tinytronix/Leselicht/README.md

Dieses Elektronik/Software-Projekt ist Teil meines Projektes "ich baue ein Bett mit viel Stauraum".
Mit einem Wemos D1 Mini und zwei WS2812B LED-Stripes wird ein Leselicht und eine Effektbeleuchtung realisiert.
Die LED-Stripes sind in das Bett eingebaut. Bedient wird das ganze mit einem optischen Dreh-Drücksteller der Firma Grayhill.
Im wesentlichen geht es hier um die Elektronik und die Software, aber unter Hardware findet sich auch eine [Konstruktionszeichnung](https://github.com/tinytronix/Leselicht/blob/master/Hardware/Konstruktion.pdf) für die Holzzuschnitte. Das Bett habe ich mit  dieser Konstruktionszeichnung inzw. 2x gebaut, die Maße sollten also stimmen. 

# Features
- Leselicht warm/weiß
- verschiedene Licht-Effekt
- Fake-TV zur Anwesenheitssimulation (angebunden an meine [Hausautomation](https://github.com/tinytronix/homeautomation))
- Lichsensor: Bettlicht an, wenn Raumlicht ausgeschaltet wird
- Konfiguration Web-Browser
- zwei Temperatursensoren
- Auslesen Temperatur, Raumhelligkeit und Systemzustände per WLAN

# Fotos
Die Hardware
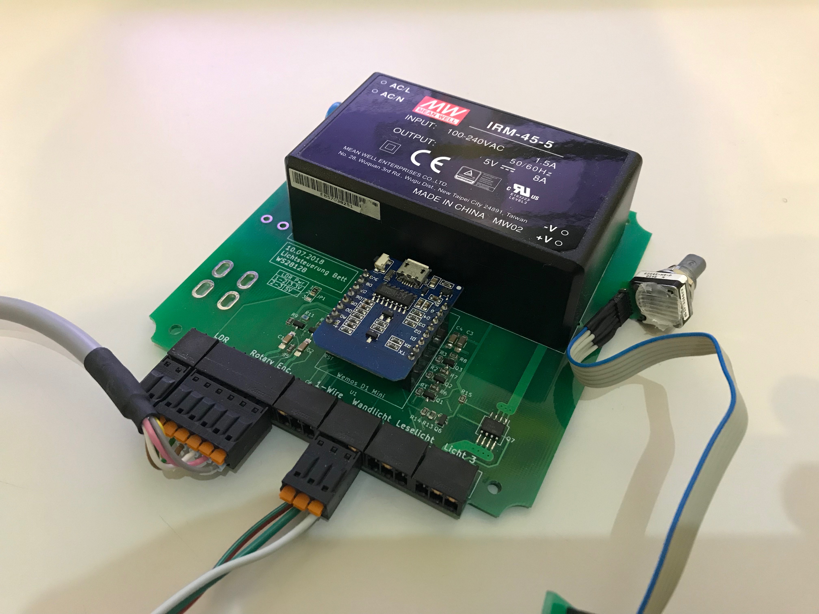
[picture p1: Photos/Hardware2.JPG]

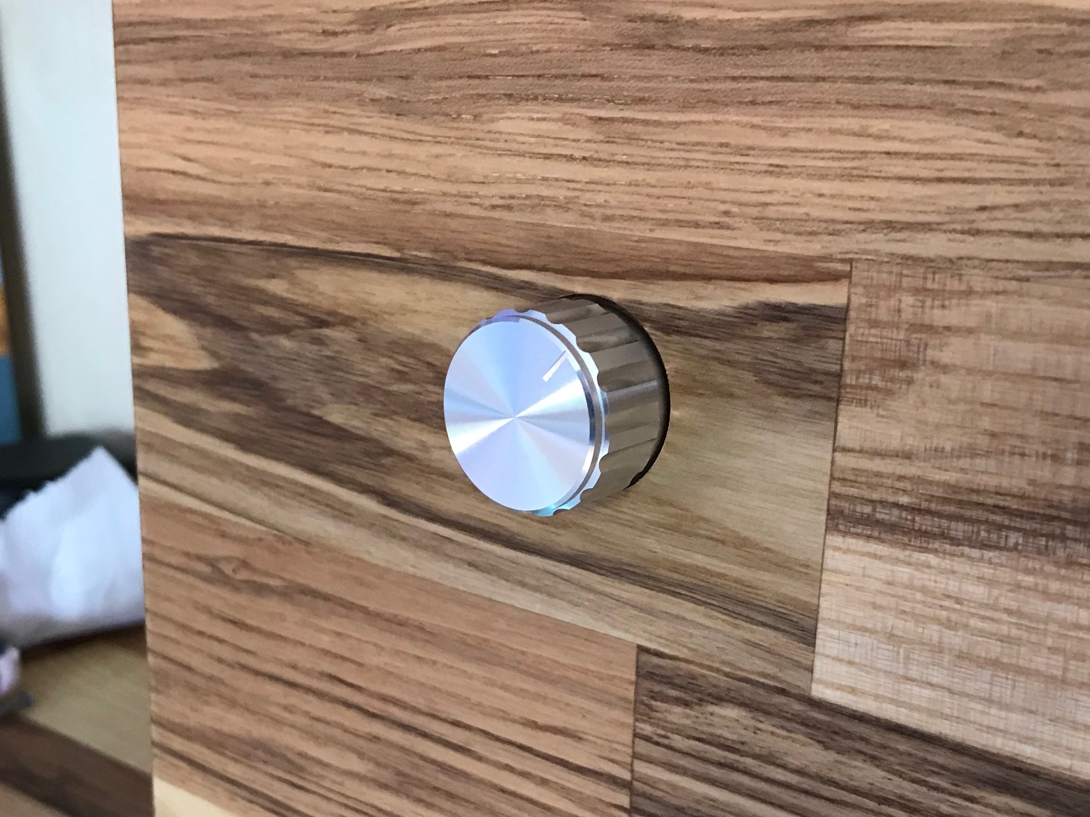
[picture p2: Photos/Drehdrueck2.JPG]

Das Bett:
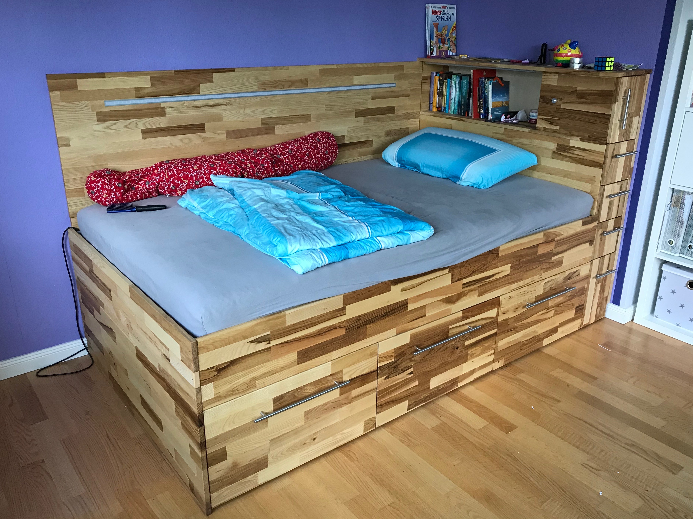
[picture p3: Photos/Bett.JPG]

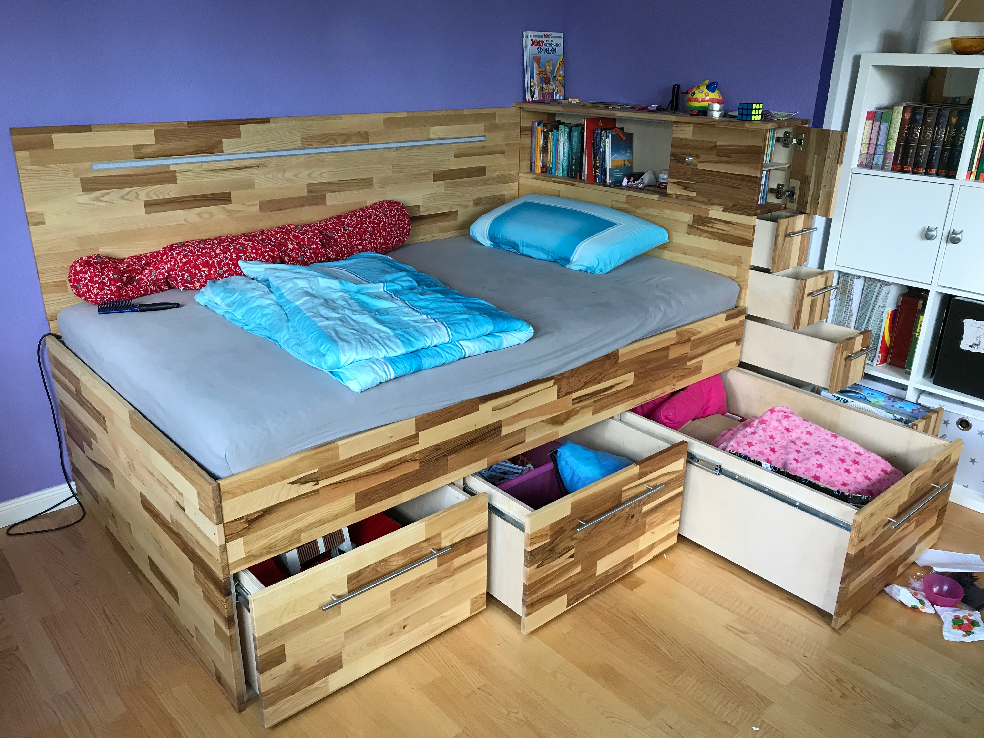
[picture p4: Photos/BettOffen.JPG]

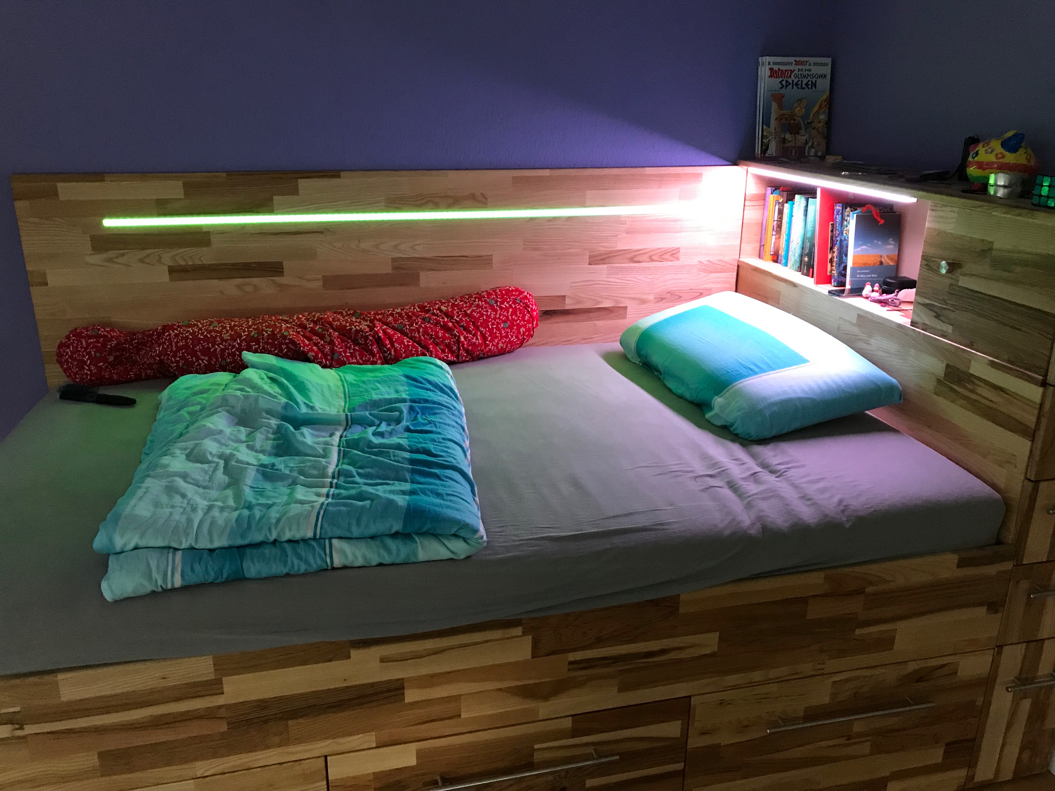
[picture p5: Photos/BettBeleuchtet.JPG]
