tinytronix/Leselicht/Hardware/README.md

Die Gerber files sind "ready to use" und können direkt zu einem PCB Fertiger hochgeladen werden.
