tinytronix/Leselicht/Hardware/Zuschnitt.pdf

Bestelliste Bett (Maße in cm)

Nr | Anzahl | BxH [cm x cm] | Art | Info
1 | 1 | 124,3x64,5 | 28mm Sichtholz | Fußplatte (Alternativ: 25, 26)
2 | 3 | 67,0x122,0 | 9mm Birke Multiplex | Bettkasten Deckplatte
3 | 6 | 45,5x118,5 | 15mm Birke Multiplex | Bettkasten Seitenteile
4 | 3 | 45,5x67,0 | 6mm Birke Multiplex | Bettkasten Rückwand
5 | 3 | 10,0x64,0 | 15mm Birke Multiplex | Bettkasten Leiste vorne unten
6 | 6 | 34,0x99,1 | 15mm Birke Multiplex | Schublade Seitenwand
7 | 3 | 57,1x10,0 | 15mm Birke Multiplex | Schublade Anschraubung f. Front
8 | 3 | 57,1x97,6 | 9mm Birke Multiplex | Schublade Bodenplatte
9 | 2 | 34,0x60,1 | 9mm Birke Multiplex | Schublade Rückwand
10 | 1 | 66,7x36,0 | 18mm Sichtholz | Front Schub Mitte (Platte: 2500x400)
11 | 1 | 66,5x36,0 | 18mm Sichtholz | Front Schub rechts (Platte: 2500x400)
12 | 2 | 33,2x36,0 | 18mm Sichtholz | Front Türen links (Alternativ: 27) (Platte: 2500x400)
13 | 1 | 24,0x200,8 | 18mm Sichtholz | Front Oben quer (Platte: 2500x300)
14 | 1 | 24,3x124,1 | 18mm Buche | Front Fuß Oben (Platte: 2000x300)
15 | 1 | 122,0x92,9 | 18mm Sichtholz | Kopfplatte
16 | 1 | 92,9x20,0 | 15mm Birke Multiplex | Kopf Innen senkrecht
17 | 4 | 110,0x20,0 | 15mm Birke Multiplex | Kopf innen waagerecht
18 | 1 | 122,0x122,7 | 6mm Birke Multiplex | Kopf Rückwand
19 | 1 | 122,0x22,4 | 18mm Sichtholz | Kopf Bücherregal Boden (Platte 2500x300)
20 | 1 | 28,0x21,8 | 18mm Sichtholz | Kopf Bücherregal Seitenteil links (Platte 2500x300)
21 | 2 | 28,0x20,0 | 18mm Sichtholz | Kopf Bücherregal Seitenteil rechts (Platte 2500x300)
22 | 1 | 124,6x28,5 | 18mm Sichtholz | Kopf Deckplatte oben (Platte 1500x300)
23 | 1 | 20,0x20,0 | 6mm Birke Multiplex | Kopf Einleger Seitenfach
24 | 1 | 28,0x38,0 | 18mm Sichtholz | Kopf Fachabdeckung (Platte 2500x300)
25 | 1 | 124,3x26,0 | 18mm Sichtholz | Fußplatte Oberteil
26 | 1 | 124,3x37,1 | 18mm Sichtholz | Fußplatte Unterteil
27 | 1 | 66,7x36,0 | 18mm Sichtholz | Front Schub Links
28 | 1 | 122,2x23,1 | 18mm Sichtholz | Tür

Lange Schubladen Johanna (Maße in cm)

29 | 6 | 109,5x16,5 | 6,5mm Birke Multiplex | Lange Schublade Seitenteil
30 | 4 | 109,5x18,5 | 9mm Birke Multiplex | Lange Schublade Boden
31 | 6 | 15,4x18,5 | 9mm Birke Multiplex | Lange Schublade vorne/hinten
32 | 2 | 109,5x29,0 | 6,5mm Birke Multiplex | Lange hohe Schublade Seitenteil
33 | 2 | 27,9x18,5 | 9mm Birke Multiplex | Lange Schublade vorne/hinten
xx | 1 | 21,8x28,7 | 18mm Sichtholz | Kopfteil Tür
xx | 1 | 21,8x19,0 | 18mm Sichtholz | Kopfteil Schublade 1 Front
xx | 1 | 21,8x18,0 | 18mm Sichtholz | Kopfteil Schublade 2 Front
xx | 1 | 21,8x18,5 | 18mm Sichtholz | Kopfteil Schublade 3 Front
xx | 1 | 21,8x36,6 | 18mm Sichtholz | Kopfteil Schublade 4 Front
