tinytronix/Leselicht/Hardware/Konstruktion.pdf

# Bett

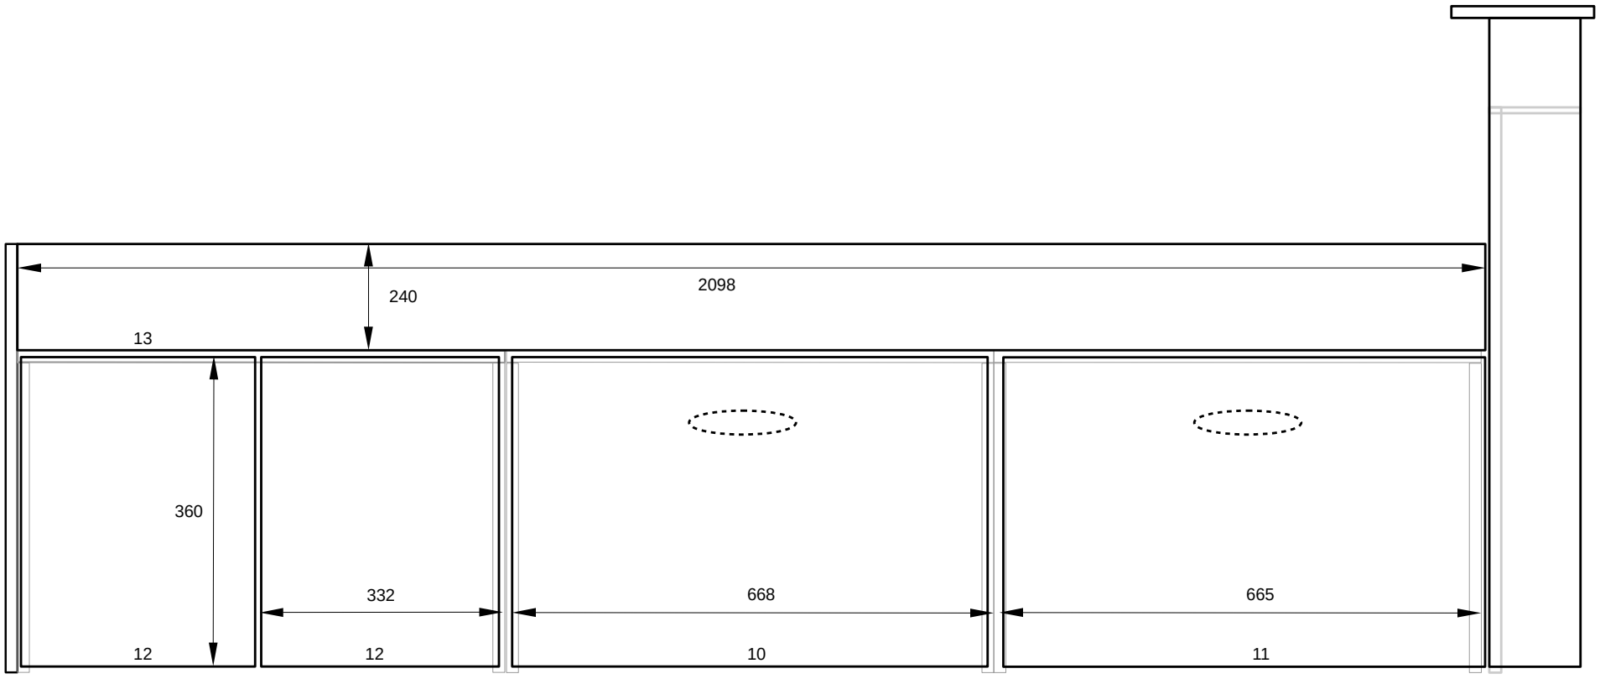
[picture p8: figure]

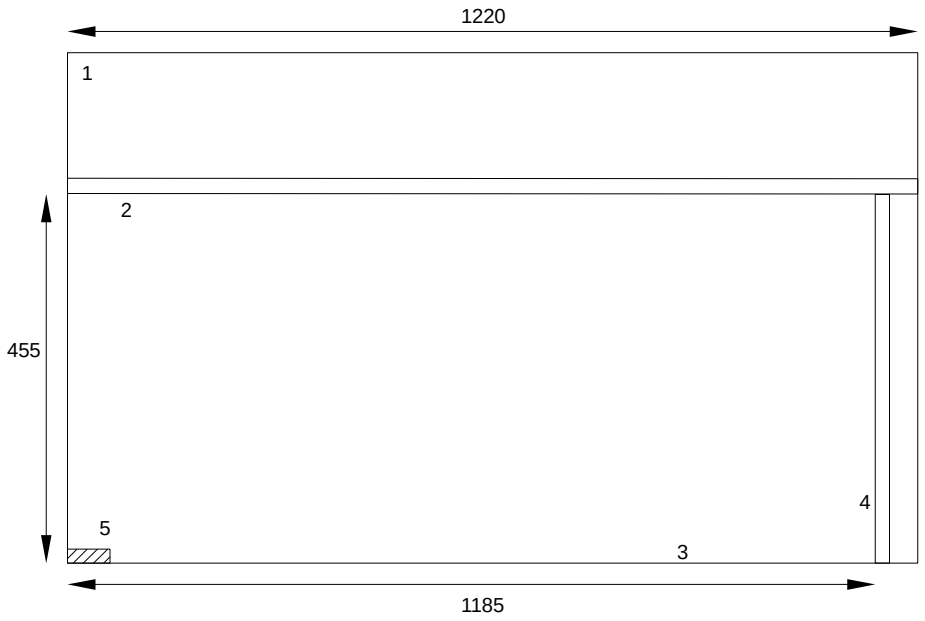
[picture p9: figure]

670
1

2

3

4

Front | Seite

# Bettkasten ohne Einschübe

619

3

455

5

# Schubladen (ohne Front)

# Bettkasten ohne Einschübe

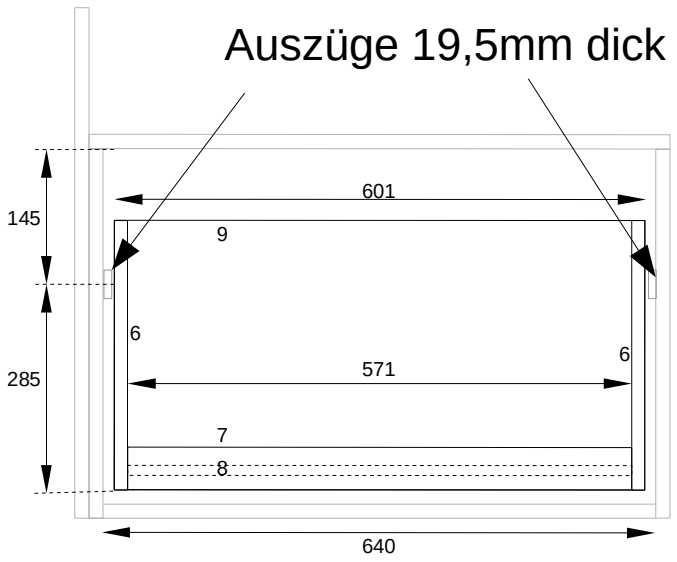
[picture p10: figure]
Auszüge 19,5mm dick
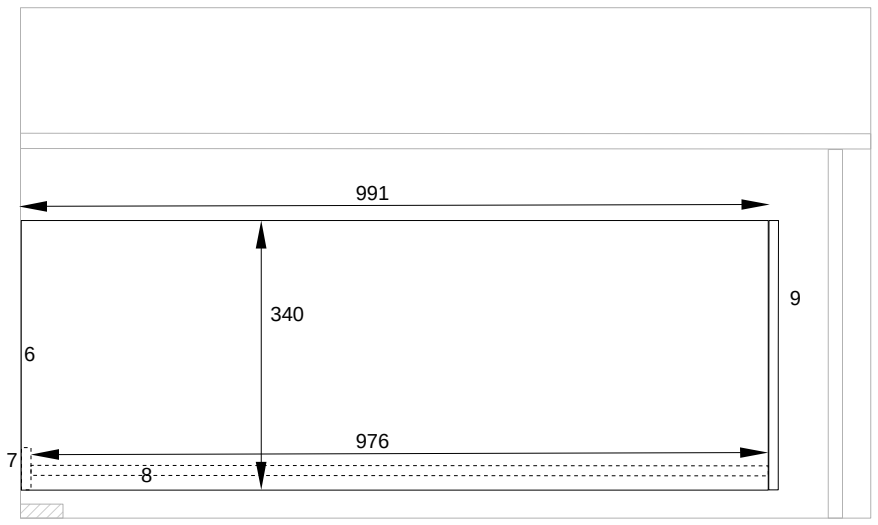
[picture p11: figure]

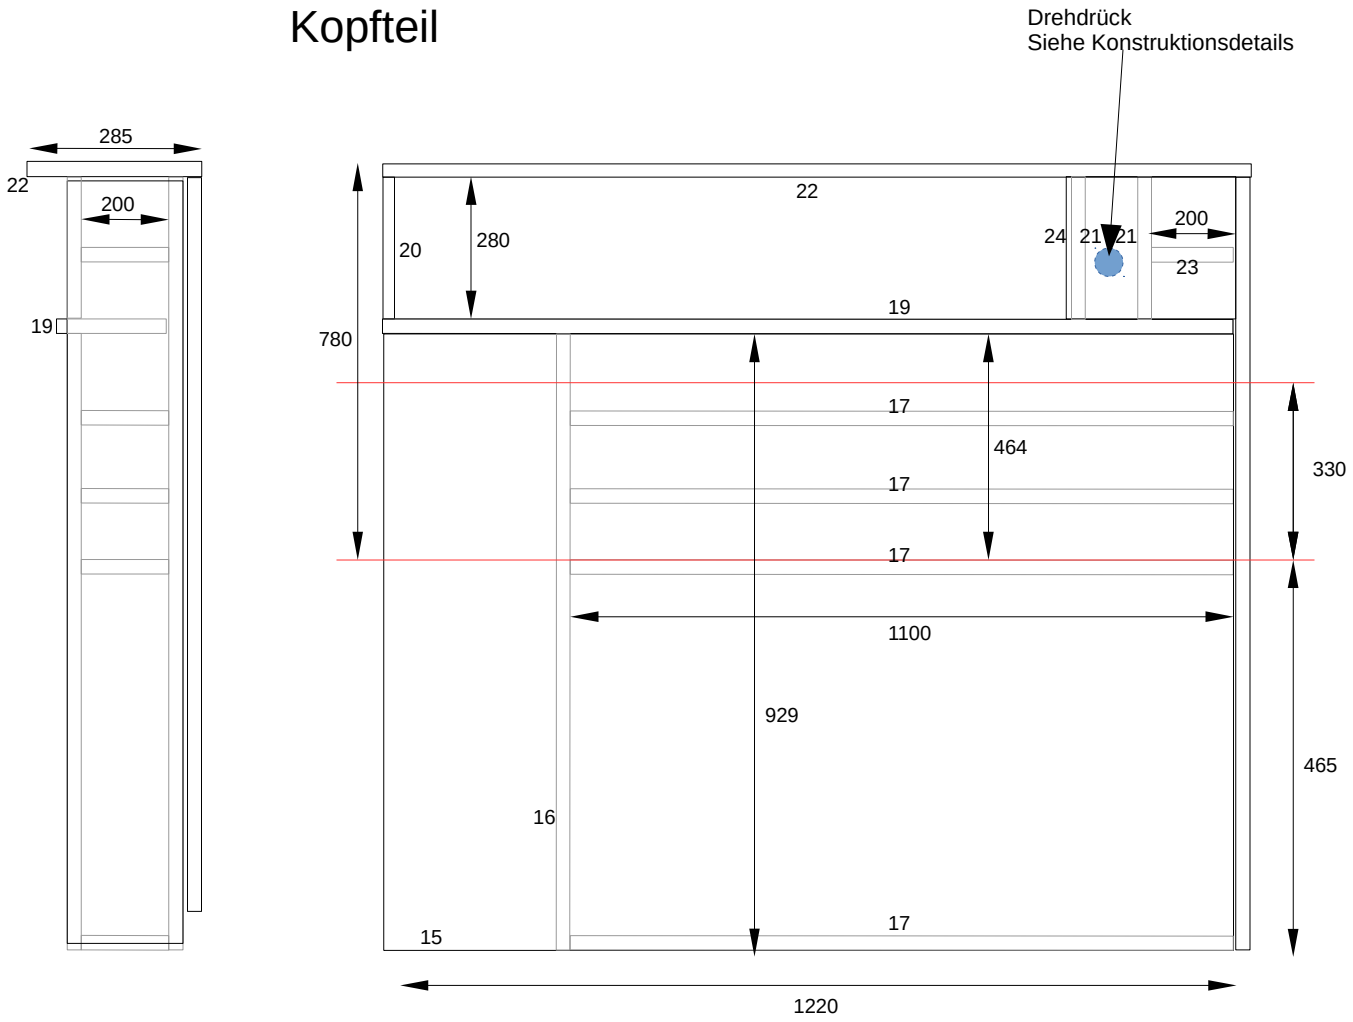
[picture p12: figure]
Kopfteil; Drehdrück Siehe Konstruktionsdetails

# Konstruktionsdetails

Drehdrück | Grayhill 62S Series
Drehdrück Knopf | www.musikding.de | Aluminium Knopf 25mm 565
Lichtschiene Corner 30° | 2M Alu Profil | Ebay Item: 171328930285 Corner 30° Innenmaß 10mm Länge: 2 Meter Breite: 20mm Höhe: 16mm Oberfläche: Natureloxiert opal (milchglas)
Lichtschiene flach | 2M Alu Profil | Ebay Item: 171328930285 Flach Innenmaß 10mm Länge: 2 Meter Breite: 20mm Höhe: 16mm Oberfläche: Natureloxiert Abdeckung: opal (milchglas)
Vollauszüge 900mm SO-Tech | Vollauszüge 80Kg / 250 -1500 mm / Schwerlastauszüge Vollauszug Schubladenauszug 19,5mm dick | Ebay Artnr. 152054023018

Bondex Hartöl 0,75l

500

2200

2

6

1243

371
1

0
360

667

2280

0

218

2200

500

1

5.1

1220

464

2200

500
15.2

1220

464

2200

600

19

1220

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
2010

230

600

12462
285

2

11
360

667

25

1243

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
# Kleine Schubläden

29

30

31 | 31

32

30

33 | 33
