tinytronix/Leselicht/Hardware/Schaltplan_Dredrueck.pdf

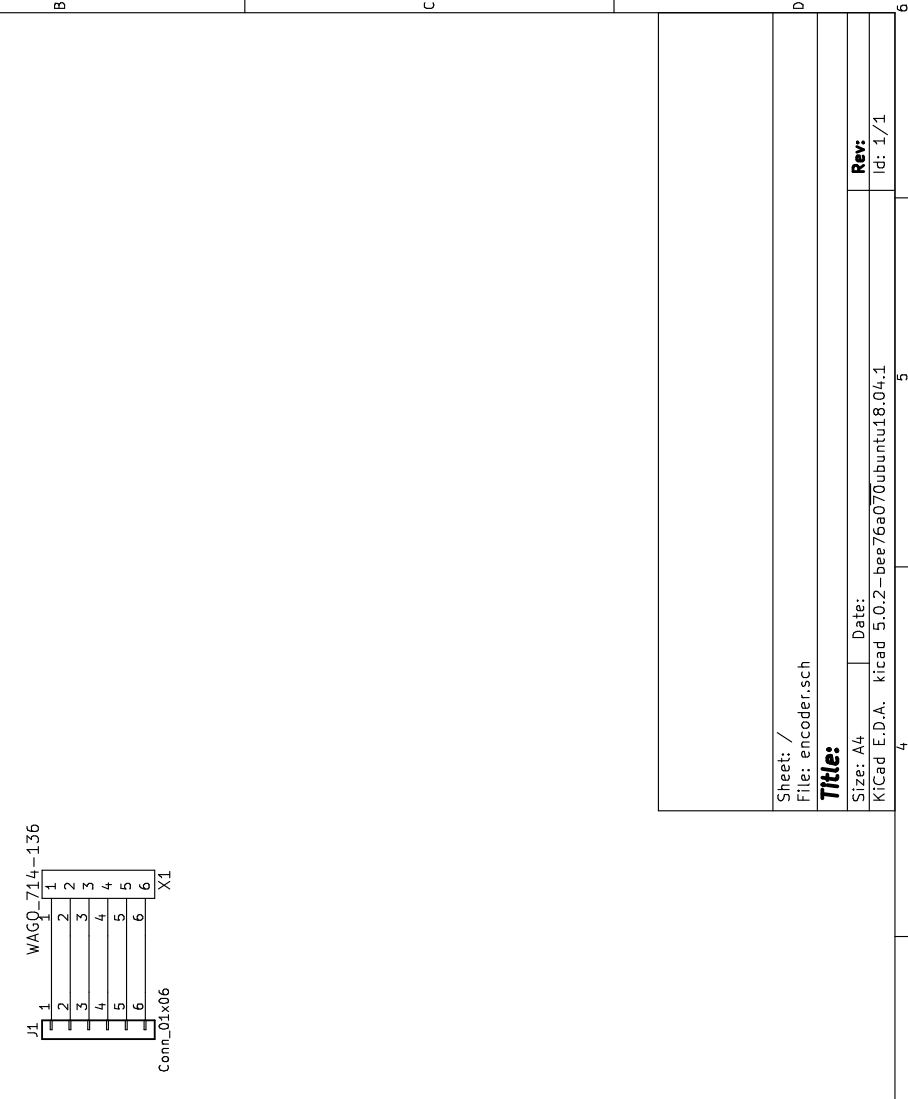
[picture p13: page 1]
