tinytronix/Leselicht/Hardware/Schaltplan_Steuerung.pdf

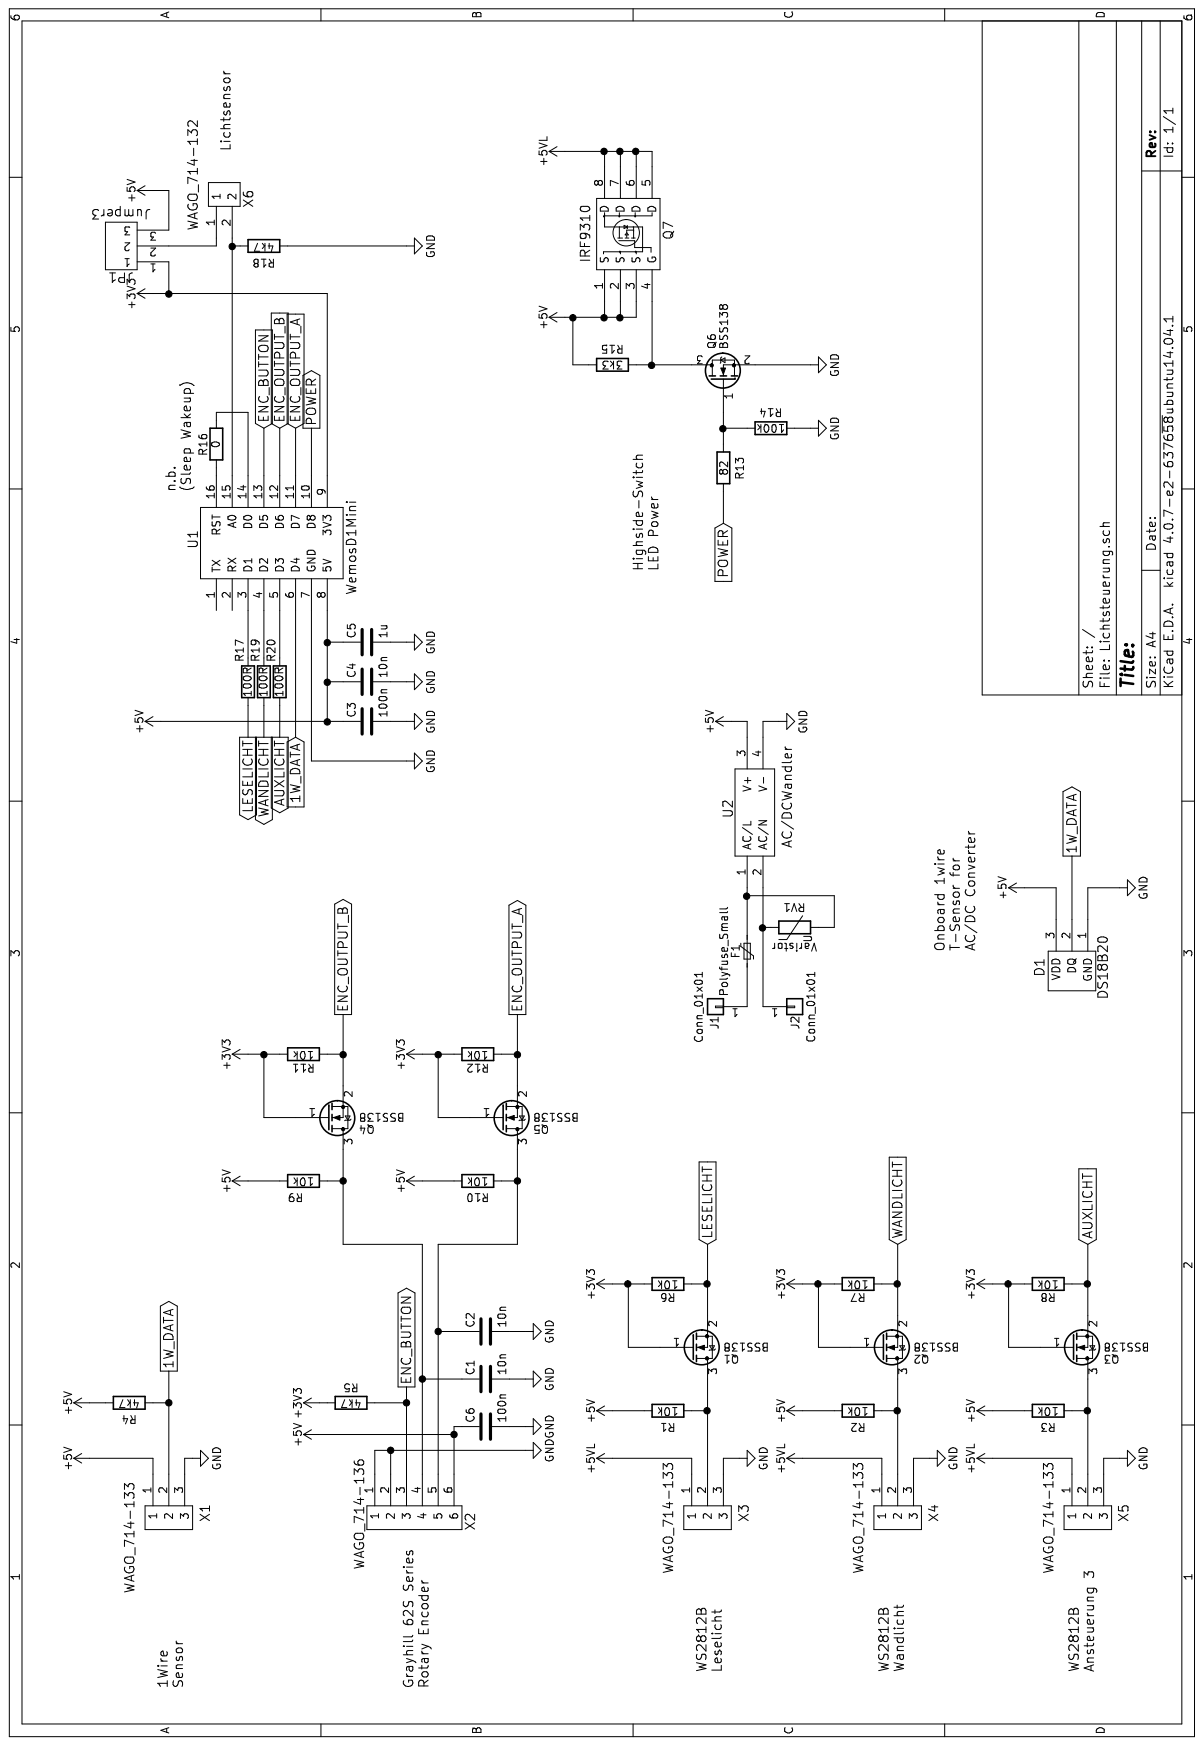
[picture p14: page 1]
