tinytronix/Leselicht/Software/faketv.h

//faketv5.h
const uint8_t  gamma8[] = {
  0X01, 0X01, 0X01, 0X02, 0X02, 0X02, 0X03, 0X03, 0X03, 0X04, 0X04, 0X04,
  0X05, 0X05, 0X05, 0X06, 0X06, 0X06, 0X07, 0X07, 0X07, 0X08, 0X08, 0X08,
  0X09, 0X09, 0X0A, 0X0B, 0X0B, 0X0B, 0X0C, 0X0C, 0X0C, 0X0D, 0X0D, 0X0D,
  0X0E, 0X0E, 0X0E, 0X10, 0X10, 0X10, 0X11, 0X11, 0X11, 0X12, 0X12, 0X12,
  0X14, 0X14, 0X14, 0X15, 0X15, 0X15, 0X17, 0X17, 0X17, 0X18, 0X18, 0X19,
  0X1A, 0X1A, 0X1A, 0X1B, 0X1C, 0X1C, 0X1D, 0X1D, 0X1E, 0X1F, 0X1F, 0X1F,
  0X21, 0X21, 0X21, 0X22, 0X23, 0X23, 0X24, 0X25, 0X25, 0X26, 0X27, 0X27,
  0X28, 0X29, 0X29, 0X2A, 0X2B, 0X2B, 0X2C, 0X2D, 0X2D, 0X2F, 0X2F, 0X30,
  0X31, 0X31, 0X32, 0X33, 0X34, 0X34, 0X36, 0X36, 0X37, 0X38, 0X38, 0X39,
  0X3A, 0X3B, 0X3C, 0X3D, 0X3E, 0X3E, 0X40, 0X40, 0X41, 0X42, 0X43, 0X43,
  0X45, 0X46, 0X46, 0X48, 0X48, 0X49, 0X4B, 0X4B, 0X4C, 0X4E, 0X4E, 0X4F,
  0X50, 0X51, 0X52, 0X54, 0X54, 0X55, 0X57, 0X57, 0X58, 0X5A, 0X5B, 0X5B,
  0X5D, 0X5E, 0X5F, 0X60, 0X61, 0X62, 0X64, 0X65, 0X65, 0X67, 0X68, 0X69,
  0X6B, 0X6C, 0X6C, 0X6E, 0X6F, 0X70, 0X72, 0X73, 0X74, 0X75, 0X76, 0X77,
  0X79, 0X7A, 0X7B, 0X7D, 0X7E, 0X7F, 0X81, 0X82, 0X83, 0X85, 0X86, 0X87,
  0X89, 0X8A, 0X8B, 0X8D, 0X8E, 0X8F, 0X91, 0X92, 0X93, 0X95, 0X96, 0X98,
  0X99, 0X9B, 0X9C, 0X9E, 0X9F, 0XA0, 0XA2, 0XA3, 0XA5, 0XA6, 0XA8, 0XA9,
  0XAB, 0XAC, 0XAE, 0XAF, 0XB1, 0XB2, 0XB4, 0XB5, 0XB7, 0XB9, 0XBA, 0XBB,
  0XBD, 0XBF, 0XC0, 0XC2, 0XC3, 0XC5, 0XC7, 0XC8, 0XCA, 0XCC, 0XCD, 0XCF,
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
  0XC3, 0X63, 0XC3, 0X63, 0XC3, 0X63, 0XC3, 0X63, 0XC3, 0X63, 0X93, 0XCC,
  0X93, 0XCC, 0X93, 0XCC, 0X93, 0XCC, 0X93, 0XCC, 0X63, 0X93, 0X63, 0X93,
  0X63, 0X93, 0X63, 0X93, 0X63, 0X93, 0X8B, 0XAE, 0X8B, 0XAE, 0X8B, 0XAE,
  0X8B, 0XAE, 0X8B, 0XAE, 0X8B, 0XAE, 0XA3, 0X48, 0XA3, 0X48, 0XA3, 0X48,
  0XA3, 0X48, 0XA3, 0X48, 0XAB, 0XA8, 0XAB, 0XA8, 0XAB, 0XA8, 0XAB, 0XA8,
  0XAB, 0XA8, 0XA4, 0XD0, 0XA4, 0XD0, 0XA4, 0XD0, 0XA4, 0XD0, 0XA4, 0XD0,
  0X8A, 0X29, 0X8A, 0X29, 0X8A, 0X29, 0X8A, 0X29, 0X71, 0XC9, 0X8A, 0X29,
  0X8A, 0X29, 0X71, 0XC9, 0X71, 0XC9, 0X94, 0XF3, 0X94, 0XF3, 0X94, 0XF3,
  0X7C, 0X31, 0X7C, 0X31, 0X94, 0XF3, 0X73, 0XF0, 0X73, 0XF0, 0X73, 0XF0,
  0X73, 0XF0, 0X73, 0XF0, 0X7C, 0X31, 0X7C, 0X31, 0X7C, 0X31, 0X7C, 0X31,
  0X7C, 0X31, 0X85, 0X15, 0X85, 0X15, 0X86, 0X7B, 0X85, 0X15, 0X86, 0X7B };
